Chrismettal/PiPLC/pcb/PiPLC-HMI/PiPLC-HMI.kicad_pcb

## KiCad design pcb/PiPLC-HMI/PiPLC-HMI.kicad_pcb (2024-02-04)

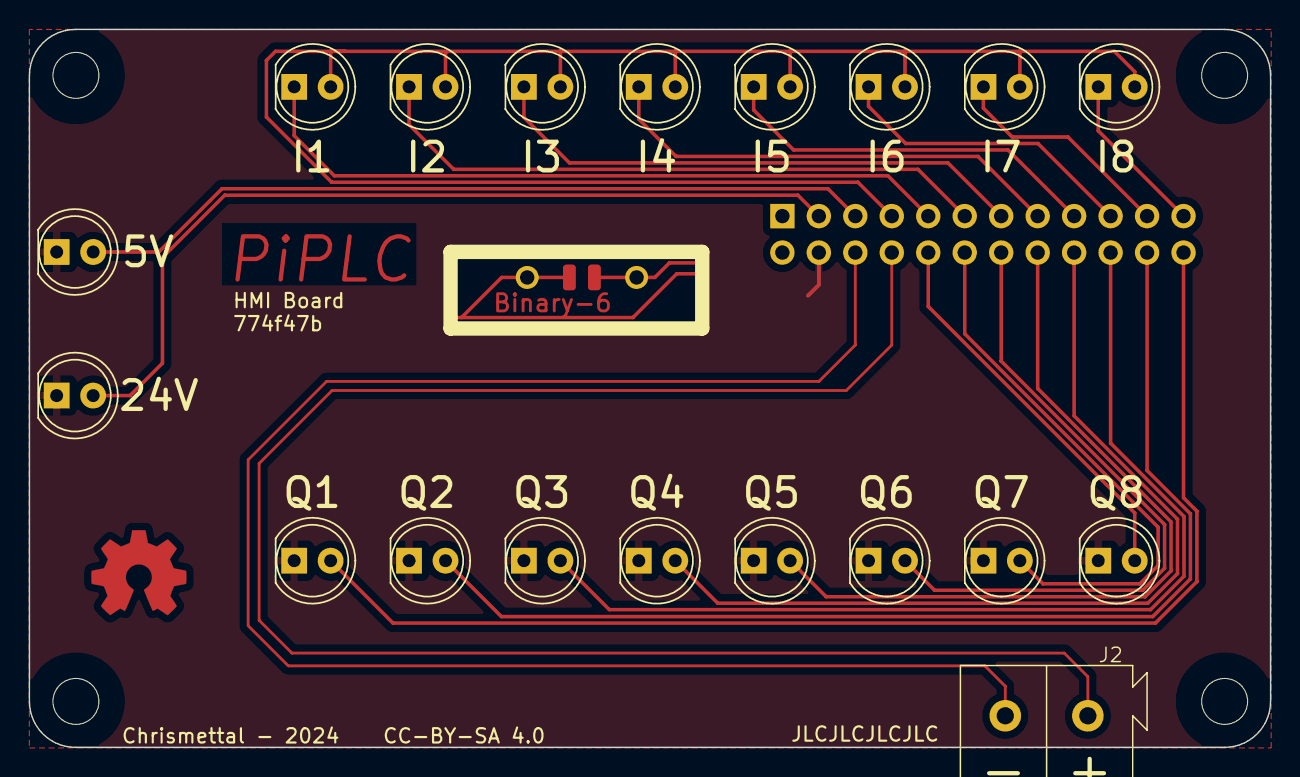
[picture p4: board PiPLC-HMI.kicad_pcb from above]

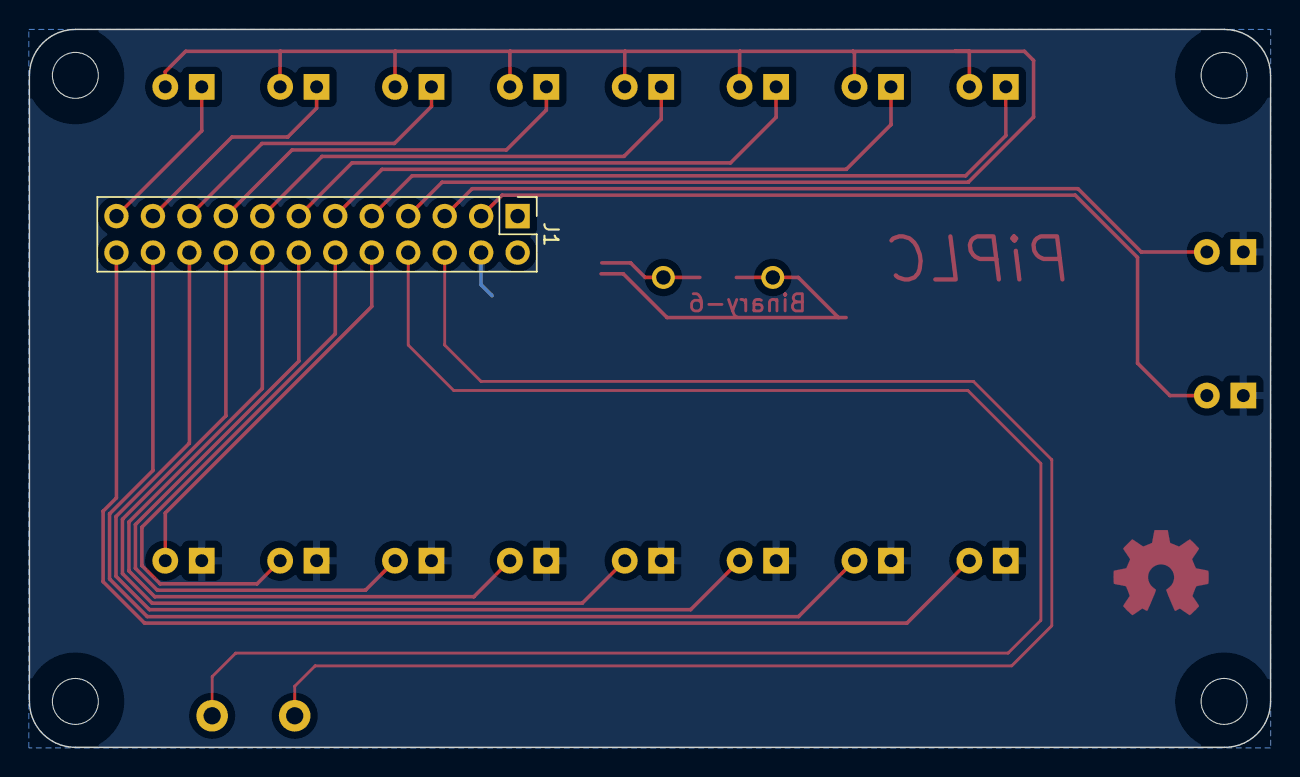
[picture p5: board PiPLC-HMI.kicad_pcb from below]

Board: 2 copper layers, 86.4 x 50.0 mm, 25 parts (5 on the bottom side), 22 nets.

Parts:
D1, D2, D3, D4, D5, D6, D7, D8, D9, D10, D11, D12, D13, D14, D15, D16: Red; LED_D5.0mm
D18, D19: Green; LED_D5.0mm
H7: Symbol_Binary6; Binary_6_v0.1
J1: Conn_02x12_Odd_Even; PinHeader_2x12_P2.54mm_Vertical
J2: KNX; KNX_Header
MK2, MK2#2, MK2#3, MK2#4: Mounting_Hole; EigenesMountingHole_3.2mm_M3_Small

Connections:
+3V3: D1.2 (A), D2.2 (A), D3.2 (A), D4.2 (A), D5.2 (A), D6.2 (A), D7.2 (A), D8.2 (A), J1.7
/KNX +: J1.8, J2.1
/KNX -: J1.6, J2.2
/LED_5V: D18.2 (A), J1.5
/LED_24V: D19.2 (A), J1.3
/LED_I1: D1.1 (K), J1.9
/LED_I2: D2.1 (K), J1.11
/LED_I3: D3.1 (K), J1.13
/LED_I4: D4.1 (K), J1.15
/LED_I5: D5.1 (K), J1.17
/LED_I6: D6.1 (K), J1.19
/LED_I7: D7.1 (K), J1.21
/LED_I8: D8.1 (K), J1.23
/LED_Q1: D9.2 (A), J1.24
/LED_Q2: D10.2 (A), J1.22
/LED_Q3: D11.2 (A), J1.20
/LED_Q4: D12.2 (A), J1.18
/LED_Q5: D13.2 (A), J1.16
/LED_Q6: D14.2 (A), J1.14
/LED_Q7: D15.2 (A), J1.12
/LED_Q8: D16.2 (A), J1.10
GND: D9.1 (K), D10.1 (K), D11.1 (K), D12.1 (K), D13.1 (K), D14.1 (K), D15.1 (K), D16.1 (K), D18.1 (K), D19.1 (K), J1.4
