Chrismettal/PiPLC/(notices)

Notices in the files:
pcb/PiPLC-Mainboard/PiPLC-Mainboard.kicad_pcb:
CC-BY-SA 4.0
pcb/PiPLC-HMI/PiPLC-HMI.kicad_pcb:
Chrismettal - 2024 CC-BY-SA 4.0
